anmh1205/MicroController_Project/4. Document/Báo cáo tiến độ lần 2/Anh_mach_thuc_te_1.jpg

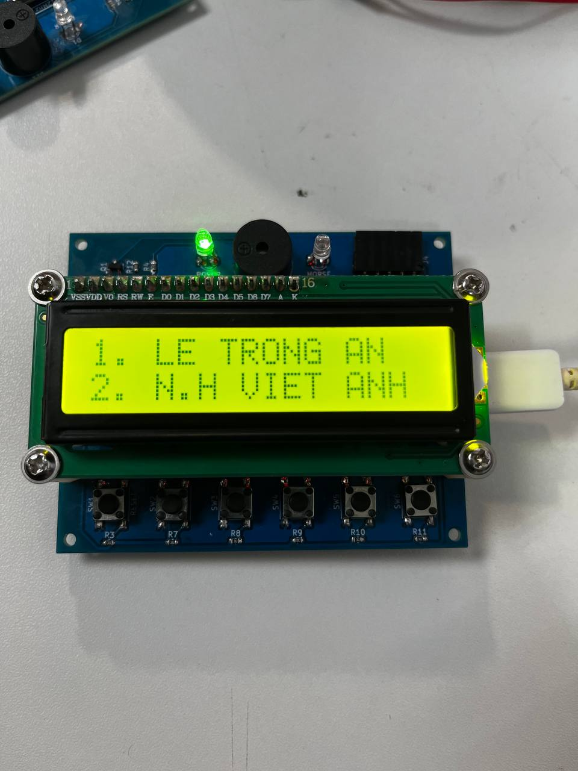
4. Document/Báo cáo tiến độ lần 2/Anh_mach_thuc_te_1.jpg
