anmh1205/MicroController_Project/0. Example/I2C LCD rev2/Pictures/Proteus Simulation SS.png

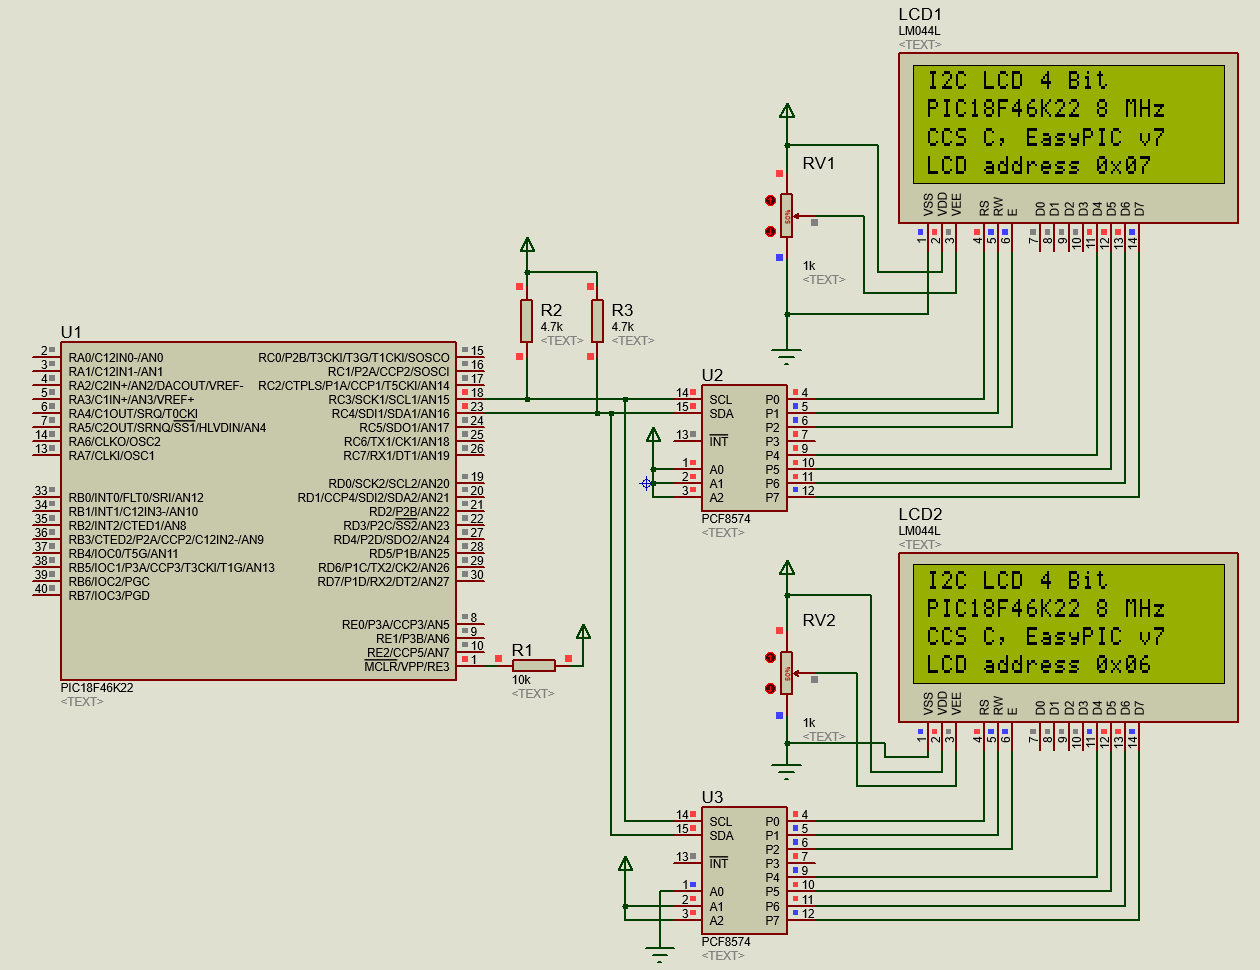
0. Example/I2C LCD rev2/Pictures/Proteus Simulation SS.png
