anmh1205/MicroController_Project/4. Document/FlowChart.png

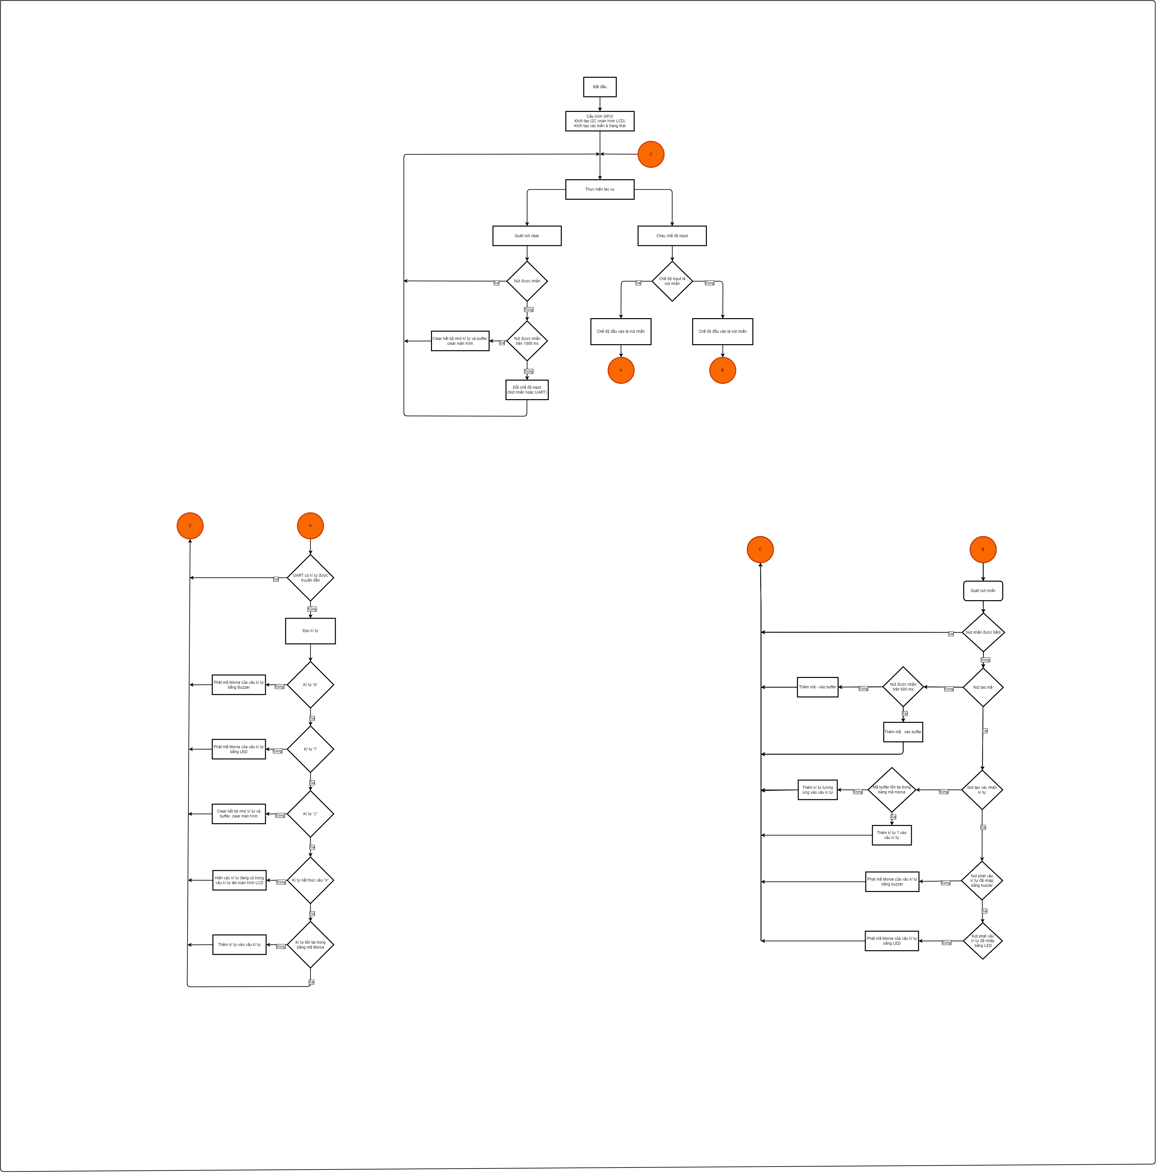
4. Document/FlowChart.png
