anmh1205/MicroController_Project/0. Example/LCD_16x2/LCD_xiamen_r1.step

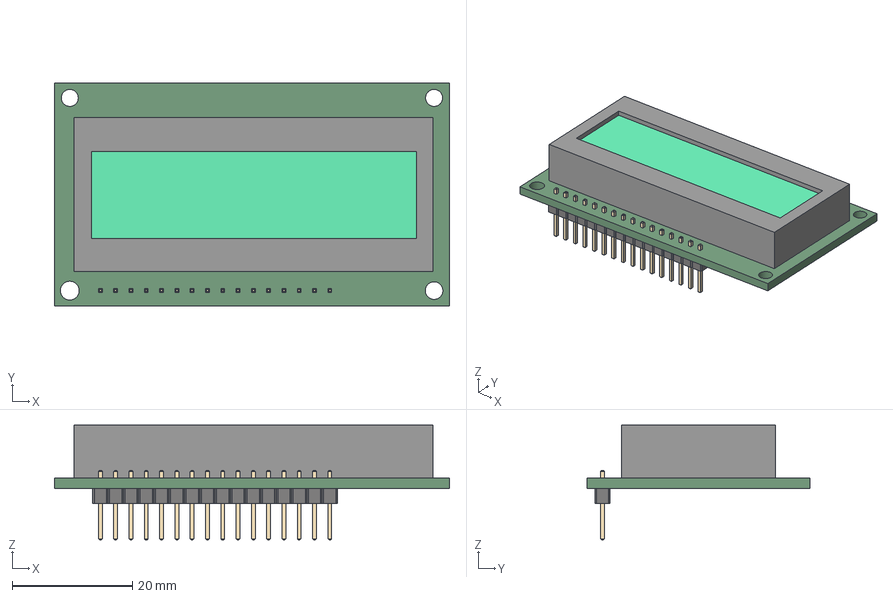
[picture p53: CAD file, 2024-07-02]
0. Example/LCD_16x2/LCD_xiamen_r1.step
65.6 x 37.0 x 19.0 mm
