anmh1205/MicroController_Project/4. Document/Báo cáo tiến độ lần 2/PCB (phần mềm KiCAD)/V1/Outline.dxf

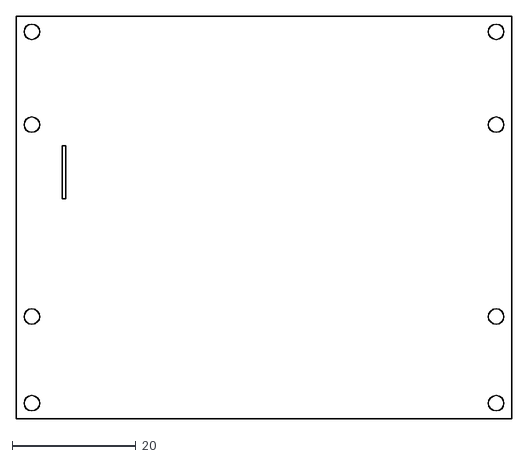
[picture p54: CAD file, 2024-07-02]
4. Document/Báo cáo tiến độ lần 2/PCB (phần mềm KiCAD)/V1/Outline.dxf
80.0 x 65.0
