anmh1205/MicroController_Project/4. Document/Báo cáo tiến độ lần 2/PCB (phần mềm KiCAD)/V1/VinaCAD5.dxf

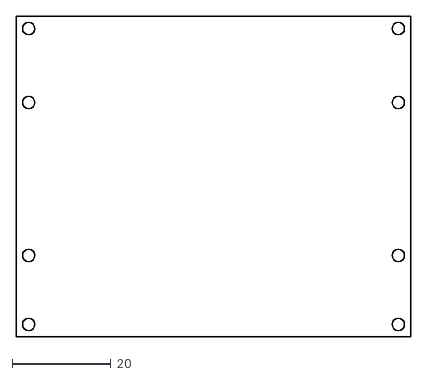
[picture p55: CAD file, 2024-07-02]
4. Document/Báo cáo tiến độ lần 2/PCB (phần mềm KiCAD)/V1/VinaCAD5.dxf
80.0 x 65.0
