anmh1205/MicroController_Project/(list of files, cad)

Other CAD files:
4. Document/Báo cáo tiến độ lần 2/PCB (phần mềm KiCAD)/V1/VinaCAD2.dxf
