anmh1205/MicroController_Project/4. Document/FlowChart.pdf

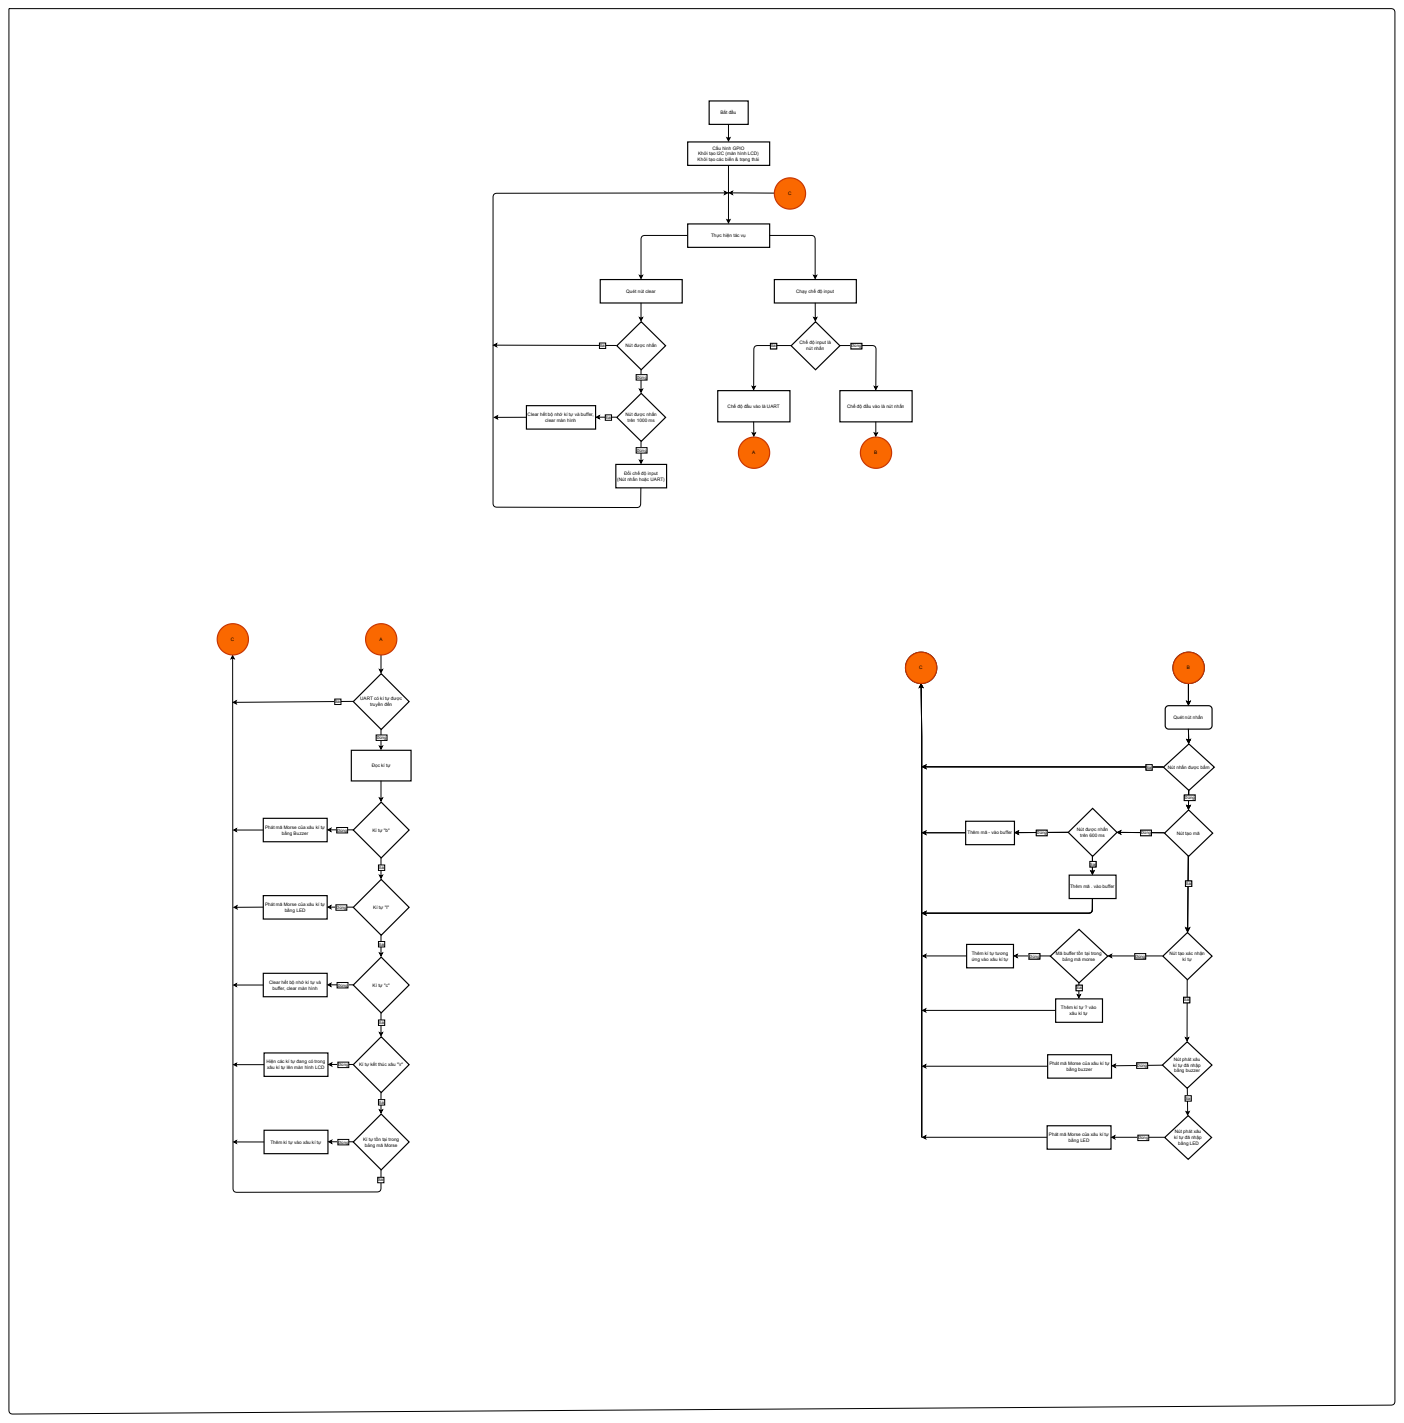
[picture p56: page 1]
Bắt đầu; Đúng; Sai; Nút được nhấn; Chế độ đầu vào là UART; Chế độ đầu vào là nút nhấn; Nút nhấn được bấm; Nút tạo mã; bằng buzzer; bằng LED; UART có kí tự được; truyền đến; Kí tự kết thúc xâu "\r"; bằng Buzzer

Cấu hình GPIO
Khởi tạo I2C (màn hình LCD)
Khởi tạo các biến & trạng thái

Thực hiện tác vụ

Quét nút clear

Chạy chế độ input

Chế độ input là
nút nhấn

Clear hết bộ nhớ kí tự và buffer,

Nút được nhấn
trên 1000 ms

clear màn hình

Đổi chế độ input
(Nút nhấn hoặc UART)

Quét nút nhấn

Đọc kí tự

Phát mã Morse của xâu kí tự

trên 600 ms

Thêm mã - vào buffer

Thêm mã . vào buffer

Thêm kí tự tương
ứng vào xâu kí tự

Mã buffer tồn tại trong
bảng mã morse

Nút tạo xác nhận

Clear hết bộ nhớ kí tự và
buffer, clear màn hình

Thêm kí tự ? vào
xâu kí tự

Hiện các kí tự đang có trong
xâu kí tự lên màn hình LCD

Nút phát xâu
kí tự đã nhập
bằng buzzer

bằng LED

Kí tự tồn tại trong
bảng mã Morse

Thêm kí tự vào xâu kí tự
