anmh1205/MicroController_Project/4. Document/Báo cáo tiến độ lần 2/PCB (phần mềm KiCAD)/V1/PCB_Schematic.pdf

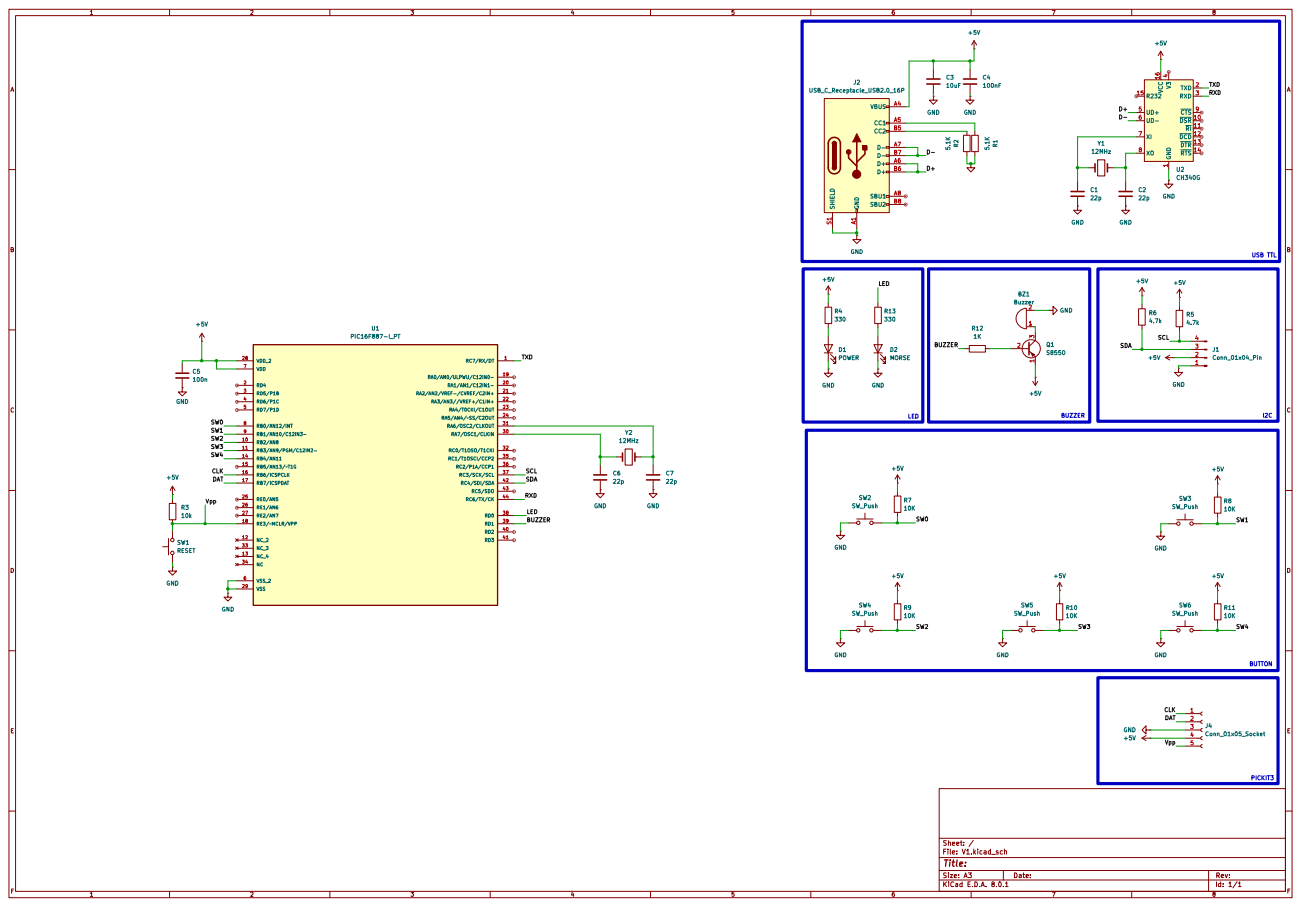
[picture p57: page 1]
