anmh1205/MicroController_Project/4. Document/Báo cáo tiến độ lần 2/SoDoNguyenLy.pdf

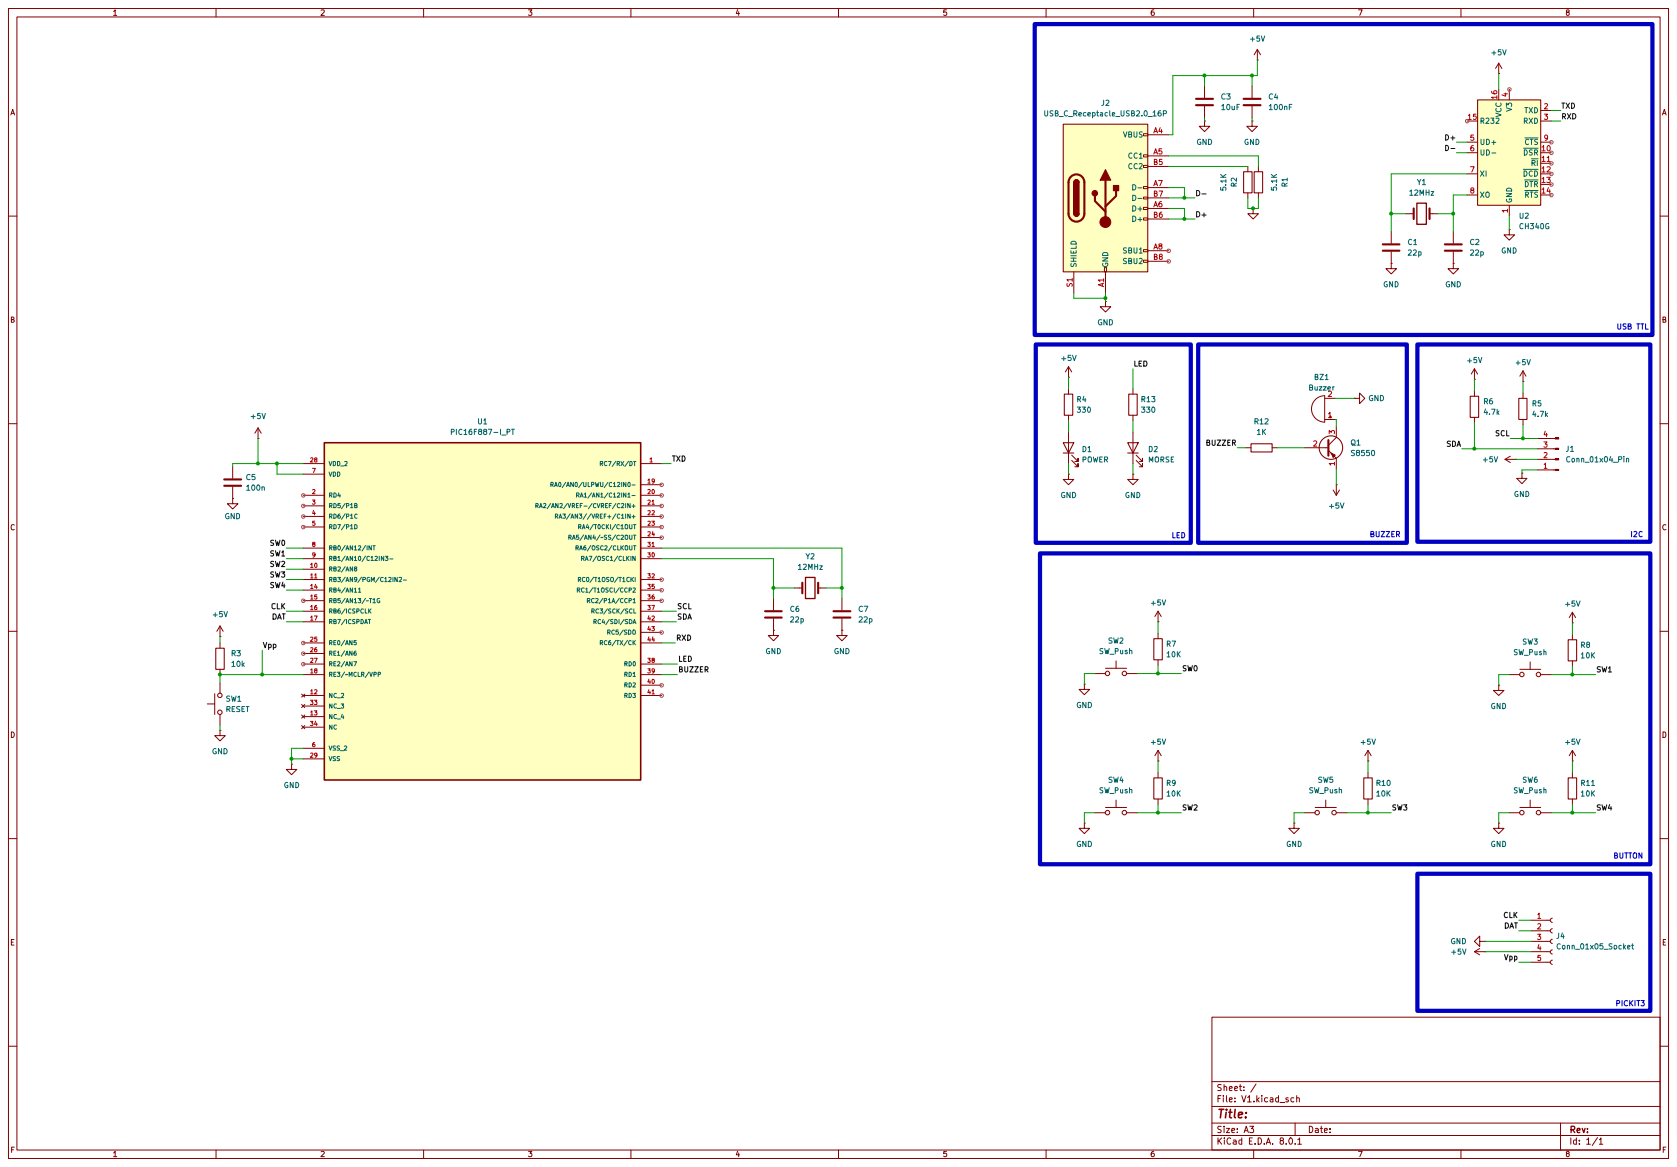
[picture p58: page 1]
