anmh1205/MicroController_Project/(list of files, drawings)

Other design files:
0. Example/12-LCD I2C/MP.pdsprj
0. Example/12-LCD I2C/Project Backups/MP [20230311, 10-53-26].pdsprj
0. Example/I2C LCD rev2/Proteus 8.2 SP2 Files/I2C LCD 4 Bit Firmware Project.pdsprj
0. Example/I2C LCD rev2/Proteus 8.2 SP2 Files/I2C LCD 4 Bit No Firmware Project.pdsprj
0. Example/LCD_I2C_PIC_CCS/Modulo_I2C_PIC16F883.pdsprj
2. PCB/Proteus/Project Backups/V1 [20240704, 06-29-56].pdsprj
2. PCB/Proteus/Project Backups/V1 [20240704, 06-29-57].pdsprj
2. PCB/Proteus/Project Backups/V1 [20240704, 06-36-14].pdsprj
2. PCB/Proteus/Project Backups/V1 [20240704, 06-36-15].pdsprj
2. PCB/Proteus/Project Backups/V1 [20240704, 09-08-23].pdsprj
2. PCB/Proteus/Project Backups/V1 [20240704, 09-17-35].pdsprj
2. PCB/Proteus/Project Backups/V1 [20240704, 09-17-36].pdsprj
2. PCB/Proteus/Project Backups/V1 [20240705, 14-09-18].pdsprj
2. PCB/Proteus/Project Backups/V1 [20240705, 14-09-30].pdsprj
2. PCB/Proteus/Project Backups/V1 [20240705, 22-51-24].pdsprj
2. PCB/Proteus/V1.pdsprj
4. Document/Báo cáo tiến độ lần 2/PCB (phần mềm KiCAD)/V1/freerouting.dsn
4. Document/Báo cáo tiến độ lần 2/PCB (phần mềm KiCAD)/V1/temp-freerouting.dsn
