anmh1205/MicroController_Project/4. Document/Báo cáo tiến độ lần 2/PCB (phần mềm KiCAD)/V1/V1.kicad_pcb

## KiCad design 4. Document/Báo cáo tiến độ lần 2/PCB (phần mềm KiCAD)/V1/V1.kicad_pcb (2024-07-07)

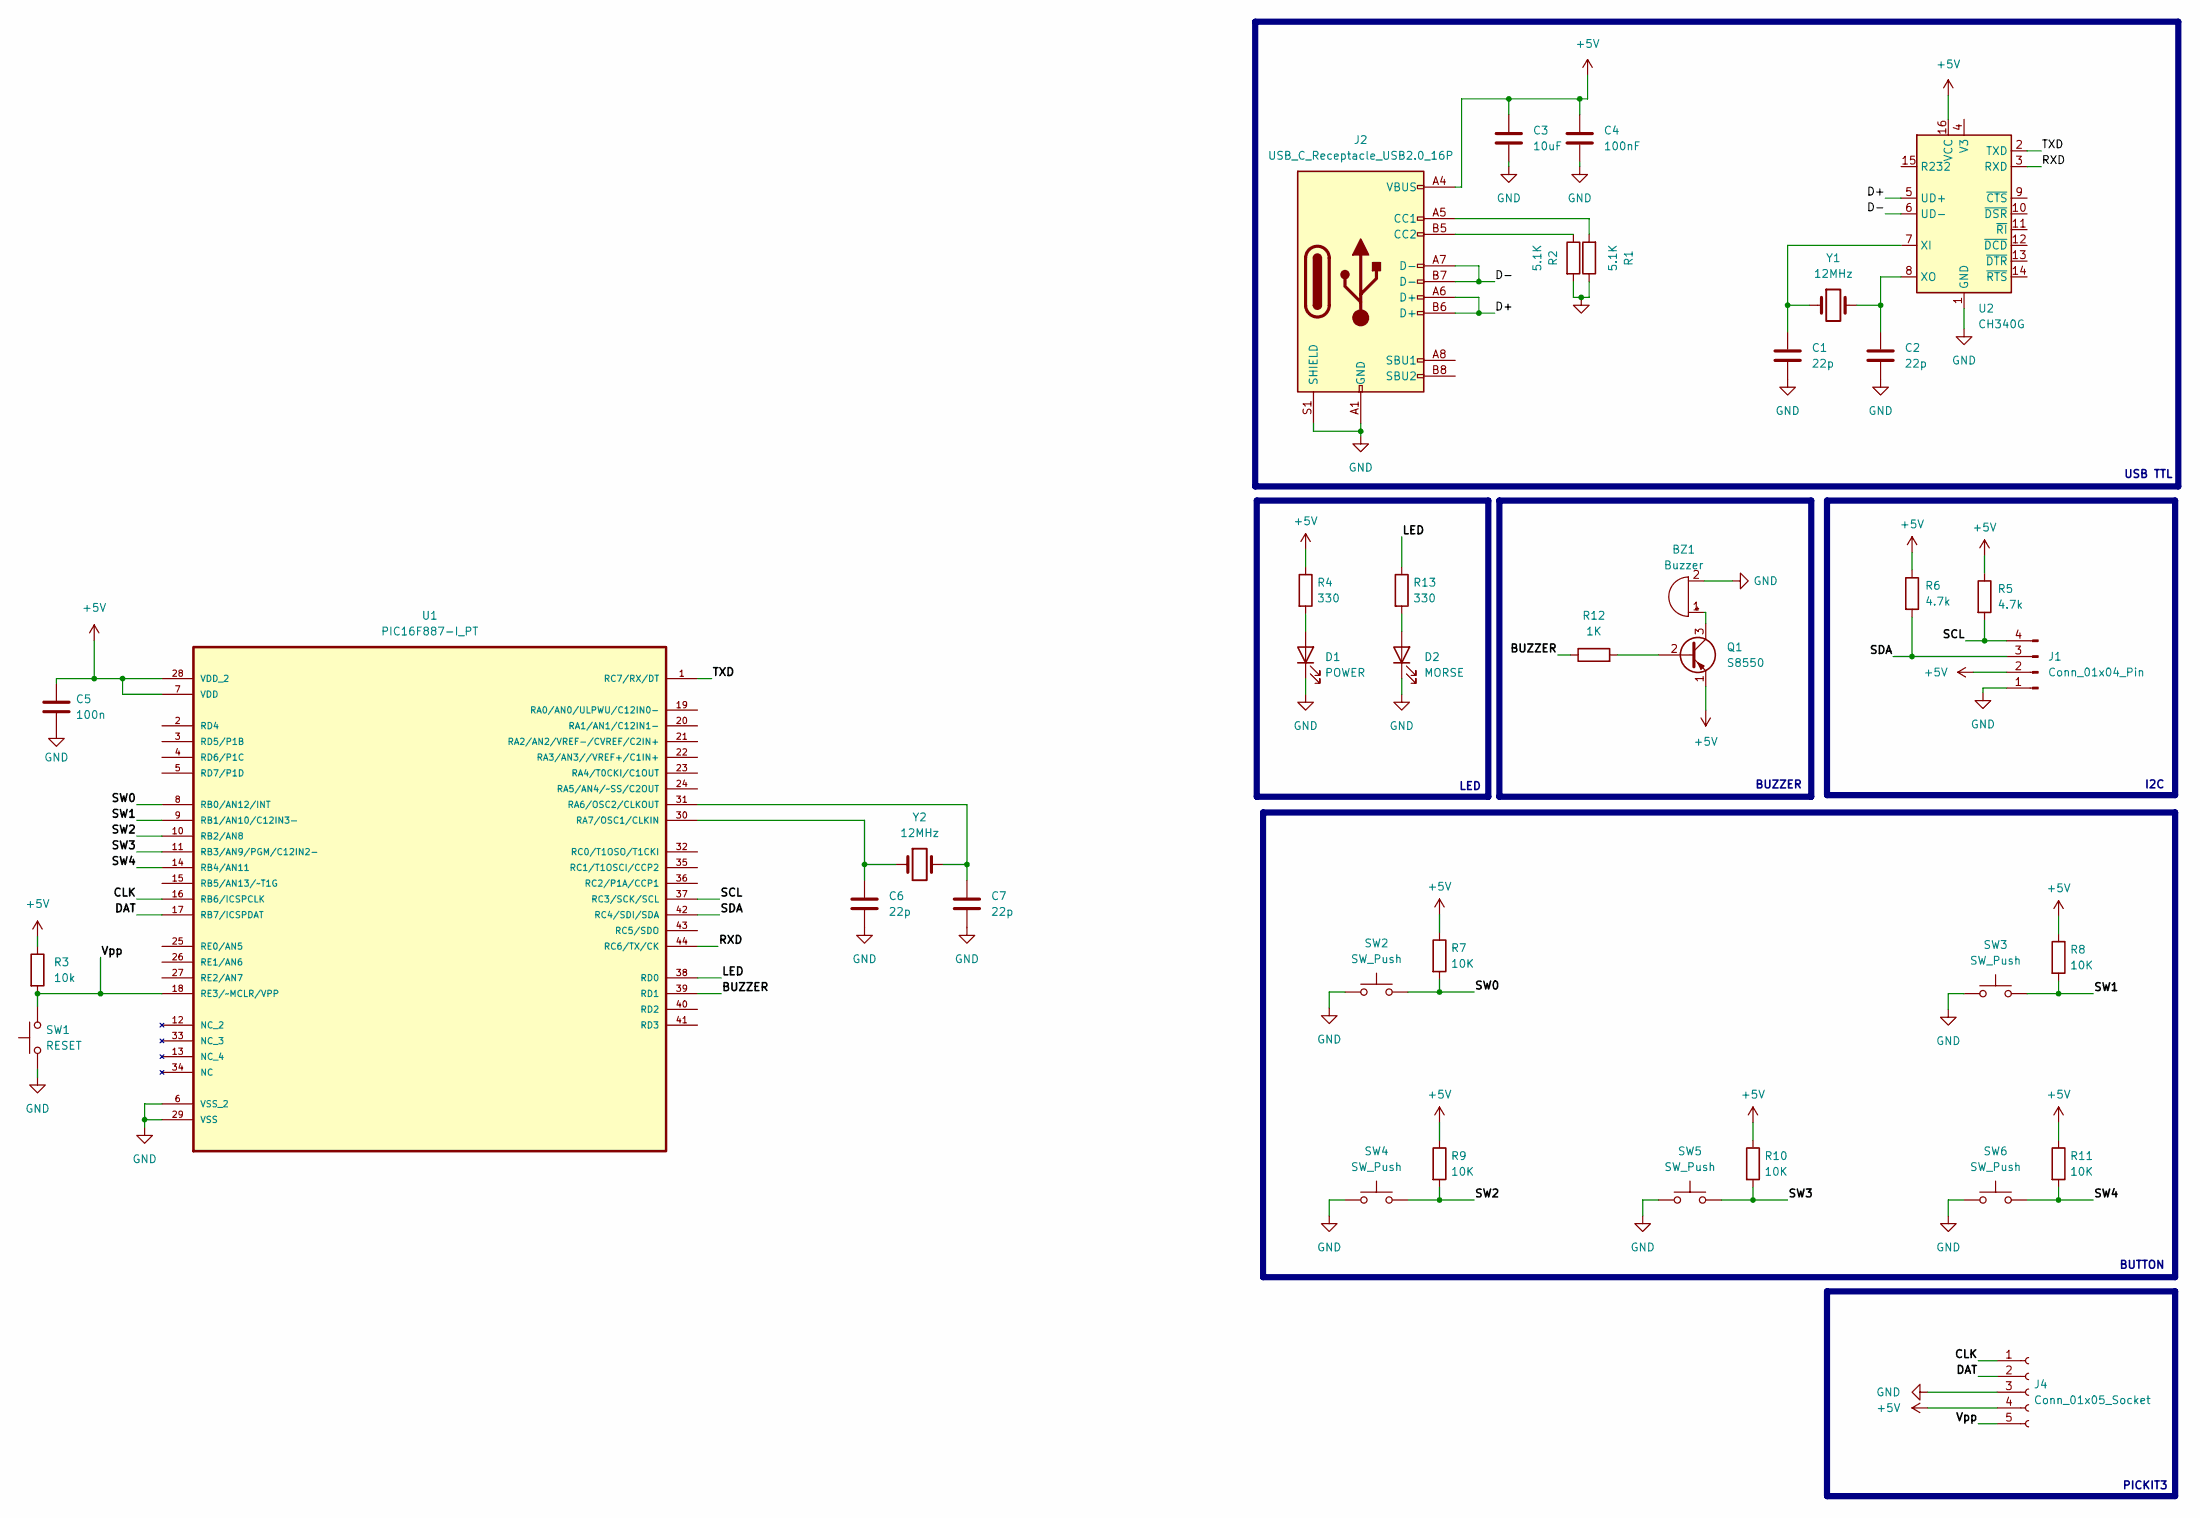
[picture p59: schematic V1.kicad_sch]

Parts:
BZ1: Buzzer; Buzzer_12x9.5RM7.6
C1, C2, C6, C7: 22p; C_0603_1608Metric
C3: 10uF; C_0603_1608Metric
C4: 100nF; C_0603_1608Metric
C5: 100n; C_0603_1608Metric
D1: POWER; LED_D3.0mm
D2: MORSE; LED_D3.0mm
J1: Conn_01x04_Pin; PinSocket_1x04_P2.54mm_Vertical
J2: USB_C_Receptacle_USB2.0_16P; USB_C_Receptacle_GCT_USB4105-xx-A_16P_TopMnt_Horizontal
J4: Conn_01x05_Socket; PinSocket_1x05_P2.54mm_Horizontal
Q1: S8550; SOT-23
R1, R2: 5.1K; C_0603_1608Metric
R3: 10k; C_0603_1608Metric
R4, R13: 330; C_0603_1608Metric
R5, R6: 4.7k; C_0603_1608Metric
R7, R8, R9, R10, R11: 10K; C_0603_1608Metric
R12: 1K; C_0603_1608Metric
SW1: RESET; SW_Push_1P1T_NO_6x6mm_H9.5mm
SW2, SW3, SW4, SW5, SW6: SW_Push; SW_Push_1P1T_NO_6x6mm_H9.5mm
U1: PIC16F887-I_PT; TQFP-44_10x10mm_P0.8mm; MPN PIC16F887-I/PT
U2: CH340G; SOIC-16_3.9x9.9mm_P1.27mm
Y1, Y2: 12MHz; Crystal_SMD_HC49-SD

Connections:
+5V: C3.1, C4.1, C5.1, J1.2, J2.A4 (VBUS), J2.A9 (VBUS), J2.B4 (VBUS), J2.B9 (VBUS), J4.4, Q1.1 (E), R3.1, R4.1, R5.1, R6.1, R7.1, R8.1, R9.1, R10.1, R11.1, U1.7 (VDD), U1.28 (VDD_2), U2.16 (VCC)
/BUZZER: R12.1, U1.39 (RD1)
/CLK: J4.1, U1.16 (RB6/ICSPCLK)
/D+: J2.A6 (D+), J2.B6 (D+), U2.5 (UD+)
/D-: J2.A7 (D-), J2.B7 (D-), U2.6 (UD-)
/DAT: J4.2, U1.17 (RB7/ICSPDAT)
/LED: R13.1, U1.38 (RD0)
/RXD: U1.44 (RC6/TX/CK), U2.3 (RXD)
/SCL: J1.4, R5.2, U1.37 (RC3/SCK/SCL)
/SDA: J1.3, R6.2, U1.42 (RC4/SDI/SDA)
/SW0: R7.2, SW2.2, U1.8 (RB0/AN12/INT)
/SW1: R8.2, SW3.2, U1.9 (RB1/AN10/C12IN3-)
/SW2: R9.2, SW4.2, U1.10 (RB2/AN8)
/SW3: R10.2, SW5.2, U1.11 (RB3/AN9/PGM/C12IN2-)
/SW4: R11.2, SW6.2, U1.14 (RB4/AN11)
/TXD: U1.1 (RC7/RX/DT), U2.2 (TXD)
/Vpp: J4.5, R3.2, SW1.2, U1.18 (RE3/~MCLR/VPP)
GND: BZ1.2 (+), C1.2, C2.2, C3.2, C4.2, C5.2, C6.2, C7.2, D1.1 (K), D2.1 (K), J1.1, J2.A1 (GND), J2.A12 (GND), J2.B1 (GND), J2.B12 (GND), J2.S1 (SHIELD), J4.3, R1.1, R2.2, SW1.1, SW2.1, SW3.1, SW4.1, SW5.1, SW6.1, U1.6 (VSS_2), U1.29 (VSS), U2.1 (GND)
unnamed: BZ1.1 (-), Q1.3 (C)
unnamed: D1.2 (A), R4.2
unnamed: D2.2 (A), R13.2
unnamed: J2.A5 (CC1), R1.2
unnamed: J2.B5 (CC2), R2.1
unnamed: Q1.2 (B), R12.2
unnamed: C7.1, U1.31 (RA6/OSC2/CLKOUT), Y2.2
unnamed: C6.1, U1.30 (RA7/OSC1/CLKIN), Y2.1
unnamed: C1.1, U2.7 (XI), Y1.1
unnamed: C2.1, U2.8 (XO), Y1.2

Notes on the sheet:
LED
BUTTON
BUZZER
I2C
PICKIT3
USB TTL

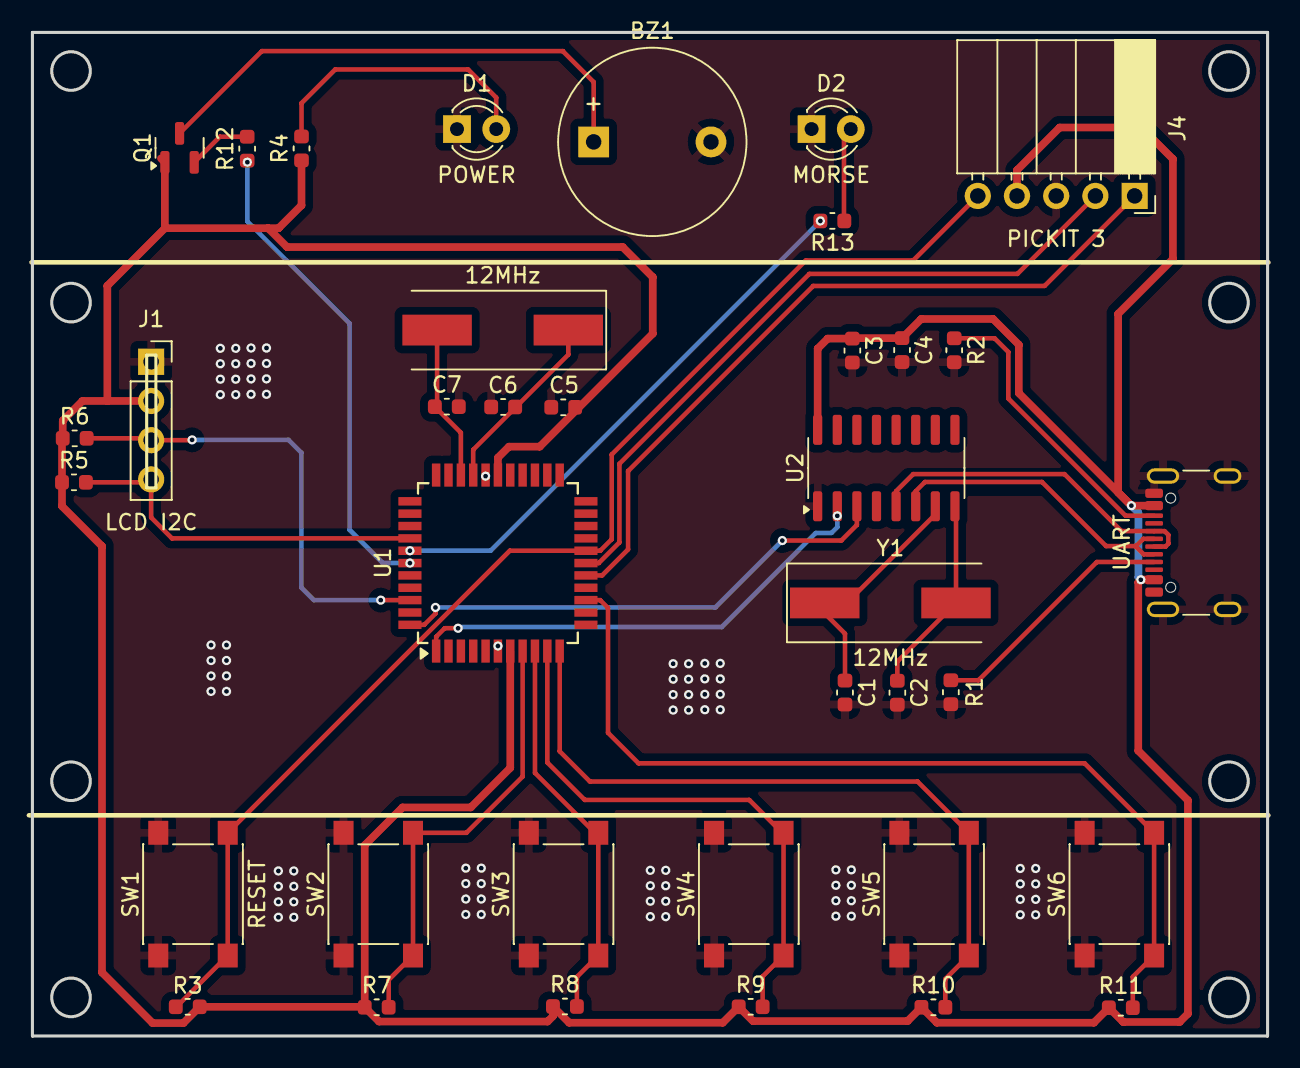
[picture p60: board V1.kicad_pcb from above]

Board: 2 copper layers, 80.0 x 65.0 mm, 37 parts (0 on the bottom side), 28 nets.
