anmh1205/MicroController_Project/0. Example/Scan_I2C/src/main.cpp

#include <Arduino.h>
#include <Wire.h>
// lcd i2c 
#include <LiquidCrystal_I2C.h>

// scan i2c address
void scanI2C() {
  byte error, address;
  int nDevices;

  Serial.println("Scanning...");

  nDevices = 0;
  for (address = 1; address < 127; address++ ) {
    Wire.beginTransmission(address);
    error = Wire.endTransmission();

    if (error == 0) {
      Serial.print("I2C device found at address 0x");
      if (address < 16) {
        Serial.print("0");
      }
      Serial.print(address, HEX);
      Serial.println(" !");
      nDevices++;
    } else if (error == 4) {
      Serial.print("Unknown error at address 0x");
      if (address < 16) {
        Serial.print("0");
      }
      Serial.println(address, HEX);
    }
  }

  if (nDevices == 0) {
    Serial.println("No I2C devices found\n");
  } else {
    Serial.println("done\n");
  }

  delay(5000);
}

void setup() {
  Serial.begin(115200);
  Wire.begin();

  // lcd i2c
  LiquidCrystal_I2C lcd(0x3F, 16, 2);
  lcd.init();
  lcd.backlight();
  lcd.setCursor(0, 0);
  lcd.print("I2C Scanner");
}

void loop()
{
  scanI2C();
}
