anmh1205/MicroController_Project/0. Example/12-LCD I2C/lcd_i2c.c

//----------------------------------------------------------------------------- 


#define LCD_ADDR  0x4E//             0x4E        //I2C slave address for LCD module 
byte lcd_total_rows = 4;//       2           //Number of rows: 1,2,3 or 4 
byte lcd_total_columns =20 ;//    16          //Number of columns: 1...20   

#define RS                    0b00000001  //P0 - PCF8574T Pin connected to RS 
#define RW                    0b00000010  //P1 - PCF8574T Pin connected to RW 
#define ENABLE                0b00000100  //P2 - PCF8574T Pin connected to EN 
#define LCD_BACKLIGHT         0b00001000  //P3 - PCF8574T Pin connected to BACKLIGHT LED 

#define addr_row_one          0x00        //LCD RAM address for row 1 
#define addr_row_two          0x40        //LCD RAM address for row 2 
#define addr_row_three        0x14        //LCD RAM address for row 3 
#define addr_row_four         0x54        //LCD RAM address for row 4 

#define ON                    1 
#define OFF                   0 
#define NOT                   ~ 
#define data_shifted          data<<4 
int8 new_row_request=1, BACKLIGHT_LED=LCD_BACKLIGHT; 

void lcd_backlight_led(byte bl) 
{  
      If (bl) BACKLIGHT_LED=LCD_BACKLIGHT; else BACKLIGHT_LED=OFF; 
} 

void i2c_send_nibble(byte data, byte type) 
{    
   switch (type) 
   {      
      case 0 :      
      i2c_write(data_shifted | BACKLIGHT_LED); 
      delay_cycles(1); 
      i2c_write(data_shifted | ENABLE | BACKLIGHT_LED ); 
      delay_us(2); 
      i2c_write(data_shifted & NOT ENABLE | BACKLIGHT_LED); 
      break; 
      
      case 1 : 
      i2c_write(data_shifted | RS | BACKLIGHT_LED); 
      delay_cycles(1); 
      i2c_write(data_shifted | RS | ENABLE | BACKLIGHT_LED ); 
      delay_us(2); 
      i2c_write(data_shifted | RS | BACKLIGHT_LED); 
      break; 
   } 
} 
    
void lcd_send_byte(byte data, byte type) 
   { 
        i2c_start(); 
        i2c_write(LCD_ADDR); 
        i2c_send_nibble(data >> 4 , type); 
        i2c_send_nibble(data & 0xf , type); 
        i2c_stop();        
   } 

void lcd_clear() 
{  
        lcd_send_byte(0x01,0); 
        delay_ms(2); 
        new_row_request=1; 
} 

void lcd_init() //byte ADDR,...byte col, byte row
{ 
   byte i;
   byte CONST lcd_type=2;  // 0=5x7, 1=5x10, 2=2 lines 
   byte CONST LCD_INIT_STRING[4] = {0x20 | (lcd_type << 2), 0xc, 1, 6}; // These bytes need to be sent to the LCD to start it up.
   
   BACKLIGHT_LED=LCD_BACKLIGHT;
   //LCD_ADDR =ADDR;//             0x4E        //I2C slave address for LCD module 
   //lcd_total_rows =row;//       2           //Number of rows: 1,2,3 or 4 
   //lcd_total_columns= col ;
   disable_interrupts(GLOBAL); 
   delay_ms(50); //LCD power up delay 
    
   i2c_start(); 
   i2c_write(LCD_ADDR); 
      i2c_send_nibble(0x00,0); 
      delay_ms(15); 
    
   for (i=1;i<=3;++i)    
   { 
      i2c_send_nibble(0x03,0); 
      delay_ms(5); 
   }    
      i2c_send_nibble(0x02,0); 
      delay_ms(5); 
   i2c_stop(); 
    
   for (i=0;i<=3;++i) { 
   lcd_send_byte(LCD_INIT_STRING[i],0); 
   delay_ms(5); 
   } 
   lcd_clear();  //Clear Display 
   enable_interrupts(GLOBAL); 
} 

void lcd_gotoxy( byte x, byte y) 
{ 
byte row,column,row_addr,lcd_address; 
//static char data; 

   if (y>lcd_total_rows) row=lcd_total_rows; else row=y; 
  
   switch(row) 
   { 
      case 1:  row_addr=addr_row_one;     break; 
      case 2:  row_addr=addr_row_two;     break; 
      case 3:  row_addr=addr_row_three;   break; 
      case 4:  row_addr=addr_row_four;    break; 
      default: row_addr=addr_row_one;     break;  
   }  
    
   if (x>lcd_total_columns) column=lcd_total_columns; else column=x;  
   lcd_address=(row_addr+(column-1)); 
   lcd_send_byte(0x80|lcd_address,0); 
} 

//Display the character on LCD screen. 
void lcd_putc(char in_data) 
{    

  switch(in_data)
   {  
     
     case '\f': lcd_clear();                       break;
      
     case '\n': 
     new_row_request++; 
     if (new_row_request>lcd_total_rows) new_row_request=1; 
     lcd_gotoxy(1, new_row_request); 
     
     break; 
                  
     case '\b': lcd_send_byte(0x10,0);             break; 
        
     default: lcd_send_byte(in_data,1);            break;      
      
   } 
} 
