anmh1205/MicroController_Project/(commit log)

2024-07-02 init commit
    [I2C LCD 4 Bit Firmware Project.pdsprj, I2C LCD 4 Bit No Firmware Project.pdsprj, LCD_xiamen_r1.step, MP [20230311, 10-53-26].pdsprj, MP.pdsprj, Outline.dxf, PIC16F887-I_PT.step, V1 [20240620, 22-58-58].pdsprj]
2024-07-04 completed pcd and lcd_i2c lib
    [Modulo_I2C_PIC16F883.pdsprj, V1 [20240620, 22-58-58].pdsprj, V1 [20240620, 23-00-07].pdsprj, V1 [20240620, 23-00-25].pdsprj, V1 [20240620, 23-00-26].pdsprj, V1 [20240620, 23-00-53].pdsprj, V1 [20240620, 23-29-46].pdsprj, V1 [20240620, 23-29-47].pdsprj]
2024-07-05 completed prototype code
    [V1 [20240704, 06-29-26].pdsprj, V1 [20240704, 06-29-45].pdsprj, V1 [20240705, 14-09-18].pdsprj, V1 [20240705, 14-09-30].pdsprj, V1.pdsprj]
2024-07-05 completed (V1.2)
    [V1 [20240704, 06-29-46].pdsprj, V1 [20240705, 22-51-24].pdsprj, V1.pdsprj]
2024-07-06 - completed morseCodeReader.c and morseCodeSpeaker.c - completed BUTTON_MODE
2024-07-06 - completed UART input mode - clearAll issue
    [main.c, main.h, morseCodeReader.c]
2024-07-07 - completed UART Mode
2024-07-07 update pcb
    [V1.kicad_pcb]
2024-07-08 done flow chart
2024-07-16 up to date Document
    [Outline.dxf, V1.kicad_pcb, V1.kicad_sch, VinaCAD2.dxf, VinaCAD5.dxf, bom.csv, designators.csv, freerouting.dsn]
2024-07-21 update document
    [Outline.dxf, V1.kicad_pcb, V1.kicad_sch, VinaCAD2.dxf, VinaCAD5.dxf, bom.csv, designators.csv, freerouting.dsn]
2024-07-27 edit timer 16MHz => 12MHz
    [V1.kicad_pcb]
